rinnai-australia/Legacy-Controls-NWSystem-NCW7/README.md

# Legacy-Controls-NWSystem-NCW7
Legacy Networker System Control - N-CW7 (Embedded Wi-Fi Option)
