rinnai-australia/Legacy-Controls-NWSystem-NCW7/(list of files, drawings)

Other design files:
Hardware/Rev00/N-CW7_Main.SchDoc
Hardware/Rev00/N-CW7_PWR_TWB.SchDoc
Hardware/Rev00/N-CW7_UserInterface.SchDoc
Hardware/Rev00/N-CW7Rev00.PrjPcb
Hardware/Rev01/N-CW7_Main.SchDoc
Hardware/Rev01/N-CW7_PWR_TWB.SchDoc
Hardware/Rev01/N-CW7_UserInterface.SchDoc
Hardware/Rev01/N-CW7Rev01.PrjPcb
