rinnai-australia/Legacy-Controls-NWSystem-NCW7/Firmware/NCW7/Source/DeviceFiles/MicrocontrollerAccess/mcuaxess_def.h

//*********************************************************************************************************************************************************************************
// mcuaxess_def.h
/*---------------------------------------------------------------------------------------------------------------------------------------------------------------------------------
 * Description: Microcontoller Access - Global Definitions.
 *
 * --------------------------------------------------------------------------------------------------------------
 * Port Pin Usage													Peripheral		Pin Configuration
 * --------------------------------------------------------------------------------------------------------------
 *	GPIOA
 *	.0  -	EEPROM WC pin.
 *	.1	-	FSH_CS1#
 *	.2	-	External interface Tx-Line.
 *	.3 	-	External interface Rx-Line.
 *	.4  -	FT800 Interrupt
 *	.5	-	FT800 SPI SCK
 *	.6	-	FT800 SPI MISO
 *	.7	-	FT800 SPI MOSI
 *	.8  -	Spare01
 *	.9  -	USB RX
 *  .10 - 	USB TX
 *  .11 -	WIFI PWR
 *  .12 - 	WIFI DTS
 *  .13 -	JTAG TMS
 *  .14 -	JTAG TCK
 *  .15 - 	JTAG TDI
 *
 *	GPIOB
 *  .0  -	Vddmes
 *  .1  - 	THM MES
 *  .2  -	BOOT1
 *	.3	-	JTAG TDO
 *	.4  - 	JTAG RESET#
 *  .5  -	WIFI ADHOC
 *  .6  - 	I2C SCL.												I2C1			OD Output @50MHz.
 *  .7  -	I2C SDA.												I2C1			OD Output @50MHz.
 *  .8  -	WIFI RESET#
 *  .9  -	WIFI WAKE
 *  .10 -	RAM HOLD#
 *  .11	- 	uSD CARD DETECT
 *  .12 -	uSD CARD CS#
 *  .13 - 	MEM SPI SCK
 *  .14 - 	MEM SPI MISO
 *  .15 - 	MEM SPI MOSI
 *
 *	GPIOC
 *  .0  -	RTC SQW
 *  .1  -	USB REG
 *  .2	-	ACL INT#
 *  .3	-	MON 5VUSB
 *  .4  -	FT800 CS#
 *  .5  -	FT800 PD#
 *  .6  -	WIFI DFLT#
 *  .7  -   TWB PWR
 *  .8  -  	WIFI CNS
 *  .9	-   WIFI AST
 *  .10 -	WIFI RX
 *  .11 -	WIFI TX
 *  .12 -	TWB TX
 *  .13	-	MON_12VLINE
 *
 *	GPIOD
 *	.2 -	TWB RX
 *
 *---------------------------------------------------------------------------------------------------------------------------------------------------------------------------------
 * Release Information.
 *---------------------------------------------------------------------------------------------------------------------------------------------------------------------------------
 *
 * Version:		N-C7  	   - v090
 * Date:		01/10/2020
 * Modifier:  	Emilio R. La Greca
 *
 * Original release.
 *
 *-------------------------------------------------------------------------------------------------------------------------------------------------------------------------------*/

#ifndef 	MCUAXESS_DEF_H_
#define	 	MCUAXESS_DEF_H_

//*********************************************************************************************************************************************************************************
// APPLICATION
//---------------------------------------------------------------------------------------------------------------------------------------------------------------------------------
// CONSTANTS
//---------------------------------------------------------------------------------------------------------------------------------------------------------------------------------
//	System Clocks & Pre-Scaling
//---------------------------------------------------------------------------------------------------------------------------------------------------------------------------------
#define			PRE_SCALER_AHB				1							// AHB Bus Pre-Scaling					- 2
#define			PRE_SCALER_APB1				2							// APB1 Bus Pre-Scaling					- 2
#define			PRE_SCALER_APB2				1							// APB2 Bus Pre-Scaling					- 1

#define			PRE_SCALER_ADC				8							// ADC Pre-Scaling						- 2

#define			HSECLOCK					8000000						// External clock frequency				- 8MHz
#define			PLLCLK						(HSECLOCK*9)				// PLL -> HSECLOCK * 9 = 72MHz			- 72MHz

#define			SYSCLK						PLLCLK						// SYSCLK								- 72MHz

#define			HCLK						(SYSCLK/PRE_SCALER_AHB)		// HCLK									- 72MHz
#define			PCLK1						(HCLK/PRE_SCALER_APB1)		// PCLK1								- 36MHz
#define			PCLK2						(HCLK/PRE_SCALER_APB2)		// PCLK2								- 72MHz
#define			TIM2CLK						PCLK1						// TIM2CLK								- 36MHz
#define			ADCCLK						(PCLK2/PRE_SCALER_ADC)		// ADCCLK								- 6MHz
//---------------------------------------------------------------------------------------------------------------------------------------------------------------------------------
//	System Interrupt Priority Levels
//---------------------------------------------------------------------------------------------------------------------------------------------------------------------------------
#define			MCUAXESS_DEF__IP_SYSTICK	14							// 10ms system tick timer
#define			MCUAXESS_DEF__IP_RTC_SECI	13							// RTC Seconds Interrupt Priority

#define			MCUAXESS_DEF__IP_USART1		12							// USART1 Interrupt Priority (USB to Serial)
#define			MCUAXESS_DEF__IP_UART5		13							// UART5 Interrupt Priority  (TWB)

#define			MCUAXESS_DEF__IP_SPI1_HI	13							// SPI1 interrupt		- FT800 SPI (Hi priority)
#define			MCUAXESS_DEF__IP_SPI1_LO	15							// SPI1 interrupt		- FT800 SPI (Lo priority)

#define			MCUAXESS_DEF__IP_I2C1_EV	13							// I2C1 EV Interrupt Priority
#define			MCUAXESS_DEF__IP_I2C1_ER	13							// I2C1 ER Interrupt Priority

#define			MCUAXESS_DEF__IP_TIM6		13							// TIM6 Interrupt Priority
//
// The following bits have not been defined in the "stm32f10x.h" file??
#if defined(STM32F10X_XL)

#define  RCC_APB1ENR_TIM6EN                 ((uint32_t)0x00000010)     	/*!< TIM6 Timer clock enable */
#define  RCC_APB1ENR_UART4EN                ((uint32_t)0x00080000)      /*!< UART 4 clock enable - Added manually, emilio */
#define  RCC_APB1ENR_UART5EN                ((uint32_t)0x00100000)      /*!< UART 5 clock enable - Added manually, emilio */

#endif /* STM32F10X_XL */
//---------------------------------------------------------------------------------------------------------------------------------------------------------------------------------
//	STRUCTURES
//---------------------------------------------------------------------------------------------------------------------------------------------------------------------------------
//
//---------------------------------------------------------------------------------------------------------------------------------------------------------------------------------
// VARIABLES
//---------------------------------------------------------------------------------------------------------------------------------------------------------------------------------
//
//---------------------------------------------------------------------------------------------------------------------------------------------------------------------------------
// SAVED VALUES
//---------------------------------------------------------------------------------------------------------------------------------------------------------------------------------
//
//---------------------------------------------------------------------------------------------------------------------------------------------------------------------------------
// TIMING
//---------------------------------------------------------------------------------------------------------------------------------------------------------------------------------
//
//---------------------------------------------------------------------------------------------------------------------------------------------------------------------------------
// FUNCTION DECLARES
//---------------------------------------------------------------------------------------------------------------------------------------------------------------------------------
//
//*********************************************************************************************************************************************************************************

#endif /* MCUAXESS_DEF_H_ */
