rinnai-australia/Legacy-Controls-NWSystem-NCW7/Firmware/NCW7/Source/SystemApplication/Management/UserInterface/TFTDisplay/Images/Heating/uitftdsp_image_heating.c

//*********************************************************************************************************************************************************************************
// uitftdsp_image_heating.c
/*---------------------------------------------------------------------------------------------------------------------------------------------------------------------------------
 * Release Information.
 *---------------------------------------------------------------------------------------------------------------------------------------------------------------------------------
 *
 * Version:		N-C7  	   - v090
 * Date:		01/10/2020
 * Modifier:  	Emilio R. La Greca
 *
 * Original release.
 *
 *-------------------------------------------------------------------------------------------------------------------------------------------------------------------------------*/

#include		<com_defn.h>
#include		<uitftdsp_image_heating.h>
#include		<uitftdsp_image_common.h>

//*********************************************************************************************************************************************************************************
// MODULE
//---------------------------------------------------------------------------------------------------------------------------------------------------------------------------------
// CONSTANTS
//---------------------------------------------------------------------------------------------------------------------------------------------------------------------------------
// INDIVIDUAL IMAGE TABLES - As images added update : mkaHeatingImageDefinition[], and
//													  UITFTDSP_IMAGE_HEATING__MAX_IMAGES.
//---------------------------------------------------------------------------------------------------------------------------------------------------------------------------------
// ('file properties: ', 'resolution ', 50, 'x', 112, 'format ', 'ARGB1555', 'stride ', 100, ' total size ', 11200) - flame_icon_141210
static const uint8_t 	mkaucFlameIcon[11200] =
{
		255,127,255,127,255,127,255,127,255,127,255,127,255,127,  0,124,  0,124,  0,124,  0,124,  0,124,  0,124,  0,124,  0,124,  0,124,  0,124,  0,124,  0,124,  0,124,  0,124,  0,124,  0,124,  0,124,  0,124,  0,124,  0,124,  0,124,  0,124,  0,124,  0,124,  0,124,  0,124,  0,124,  0,124,  0,124,  0,124,  0,124,  0,124,255,127,255,127,255,127,255,127,255,127,255,127,255,127,255,127,255,127,255,127,255,127,
		255,127,255,127,255,127,255,127,255,127,255,127,255,127,  0,124,  0,124,  0,124,  0,124,  0,124,  0,124,  0,124,  0,124,  0,124,  0,124,  0,124,  0,124,  0,124,  0,124,  0,124,  0,124,  0,124,  0,124,  0,124,  0,124,  0,124,  0,124,  0,124,  0,124,  0,124,  0,124,  0,124,  0,124,  0,124,  0,124,  0,124,  0,124,255,127,255,127,255,127,255,127,255,127,255,127,255,127,255,127,255,127,255,127,255,127,
		255,127,255,127,255,127,255,127,255,127,255,127,255,127,  0,124,  0,124,  0,124,  0,124,  0,124,  0,124,  0,124,  0,124,  0,124,  0,124,  0,124,  0,252,  0,124,  0,124,  0,124,  0,124,  0,124,  0,124,  0,124,  0,124,  0,124,  0,124,  0,124,  0,124,  0,124,  0,124,  0,124,  0,124,  0,124,  0,124,  0,124,  0,124,255,127,255,127,255,127,255,127,255,127,255,127,255,127,255,127,255,127,255,127,255,127,
		255,127,255,127,255,127,255,127,255,127,255,127,255,127,  0,124,  0,124,  0,124,  0,124,  0,124,  0,124,  0,124,  0,124,  0,124,  0,124,  0,124,  0,252,  0,124,  0,124,  0,124,  0,124,  0,124,  0,124,  0,124,  0,124,  0,124,  0,124,  0,124,  0,124,  0,124,  0,124,  0,124,  0,124,  0,124,  0,124,  0,124,  0,124,255,127,255,127,255,127,255,127,255,127,255,127,255,127,255,127,255,127,255,127,255,127,
		255,127,255,127,255,127,255,127,255,127,255,127,255,127,  0,124,  0,124,  0,124,  0,124,  0,124,  0,124,  0,124,  0,124,  0,124,  0,124,  0,124,  0,252,  0,252,  0,124,  0,124,  0,124,  0,124,  0,124,  0,124,  0,124,  0,124,  0,124,  0,124,  0,124,  0,124,  0,124,  0,124,  0,124,  0,124,  0,124,  0,124,  0,124,255,127,255,127,255,127,255,127,255,127,255,127,255,127,255,127,255,127,255,127,255,127,
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
// Collection of all images
static const struct	UITFTDSP_IMAGE_COMMON__ImageDefinition	mkaHeatingImageDefinition[UITFTDSP_IMAGE_HEATING__MAX_IMAGES] = {

	{ mkaucFlameIcon, 			sizeof(mkaucFlameIcon), 		   100,  50, 112 },
	{ mkaucLightningBoltIcon, 	sizeof(mkaucLightningBoltIcon),     96,  48, 112 },			// Added, NC7090_DFDISP
};
//---------------------------------------------------------------------------------------------------------------------------------------------------------------------------------
// VARIABLES
//---------------------------------------------------------------------------------------------------------------------------------------------------------------------------------
static UITFTDSP_IMAGE_COMMON__ImageDetails	maHeatingImage[UITFTDSP_IMAGE_HEATING__MAX_IMAGES];
//---------------------------------------------------------------------------------------------------------------------------------------------------------------------------------
// SAVED VALUES
//---------------------------------------------------------------------------------------------------------------------------------------------------------------------------------
//
//---------------------------------------------------------------------------------------------------------------------------------------------------------------------------------
// TIMING
//---------------------------------------------------------------------------------------------------------------------------------------------------------------------------------
//
//---------------------------------------------------------------------------------------------------------------------------------------------------------------------------------
// FUNCTION DECLARES
//---------------------------------------------------------------------------------------------------------------------------------------------------------------------------------
//
//*********************************************************************************************************************************************************************************


//*********************************************************************************************************************************************************************************
// APPLICATION
//---------------------------------------------------------------------------------------------------------------------------------------------------------------------------------
// VARIABLES
//---------------------------------------------------------------------------------------------------------------------------------------------------------------------------------
//
//---------------------------------------------------------------------------------------------------------------------------------------------------------------------------------
// FUNCTION DEFINITIONS
/*---------------------------------------------------------------------------------------------------------------------------------------------------------------------------------
 * @brief:	Initialise heating specific image interface.
 * @param:	None.
 * @retval:	None.
 *-------------------------------------------------------------------------------------------------------------------------------------------------------------------------------*/
void									UITFTDSP_IMAGE_HEATING__Initialise(void)
{
	uint16_t	uiIndex;

	for ( uiIndex = 0; uiIndex < UITFTDSP_IMAGE_HEATING__MAX_IMAGES; uiIndex++ )
	{
		maHeatingImage[uiIndex].ulRAMStartAddx = 0;
	}

	return;
}
/*--------------------------------------------------------------------------------------------------------------------------------
 * @brief:	Returns a pointer to the image details.
 * @param:	vImageNumber:
 * 				- the image number of type : UITFTDSP_IMAGE_HEATING__IMAGE_NUMBER.
 * @retval:	Pointer to UITFTDSP_IMAGE_COMMON__ImageDetails.
 *------------------------------------------------------------------------------------------------------------------------------*/
UITFTDSP_IMAGE_COMMON__ImageDetails*	UITFTDSP_IMAGE_HEATING__pImage(UITFTDSP_IMAGE_HEATING__IMAGE_NUMBER vImageNumber)
{
	UITFTDSP_IMAGE_COMMON__ImageDetails*	pImage = COM_DEFN__NULL;

	if ( vImageNumber < UITFTDSP_IMAGE_HEATING__MAX_IMAGES )
	{
		// Get the image using number as index
		pImage = &maHeatingImage[vImageNumber];
		// Assign the image definition details
		pImage->pDefinition = &mkaHeatingImageDefinition[vImageNumber];
	}

	return pImage;
}
//*********************************************************************************************************************************************************************************
