rinnai-australia/Legacy-Controls-NWSystem-NCW7/Firmware/NCW7/Source/SystemApplication/Management/NetworkerSystem/Access/Ancillary/PinEntry/Control/nws_pinent_control.h

//*********************************************************************************************************************************************************************************
// nws_pinent_control.h
/*---------------------------------------------------------------------------------------------------------------------------------------------------------------------------------
 * Description: Networker System Ancillary State - Pin Entry Control.
 *
 * 				Code module to allow access to pin entry in networker system.
 *---------------------------------------------------------------------------------------------------------------------------------------------------------------------------------
 * Release Information.
 *---------------------------------------------------------------------------------------------------------------------------------------------------------------------------------
 *
 * Version:		N-C7 	   - v090
 * Date:		01/10/2020
 * Modifier:  	Emilio R. La Greca
 *
 * Original release.
 *
 *-------------------------------------------------------------------------------------------------------------------------------------------------------------------------------*/

#ifndef 		NWS_PINENT_CONTROL_H_
#define 		NWS_PINENT_CONTROL_H_

#include		<com_defn.h>
#include		<nws_pinent_common.h>
#include		<genstrdt.h>

//*********************************************************************************************************************************************************************************
// APPLICATION
//---------------------------------------------------------------------------------------------------------------------------------------------------------------------------------
// CONSTANTS
//---------------------------------------------------------------------------------------------------------------------------------------------------------------------------------
typedef enum	NWS_PINENT_CONTROL__PIN_ACCESS {		// Pin Access States
														//
	NWS_PINENT_CONTROL__PA__NOT_REQUIRED  = 0,			// - Not required (default state)
	NWS_PINENT_CONTROL__PA__REQUIRED      = 1,			// - Required to access a state
	NWS_PINENT_CONTROL__PA__GRANTED   	  = 2,			// - Pin access granted
	NWS_PINENT_CONTROL__PA__CANCELLED 	  = 3			// - Pin access cancelled

} NWS_PINENT_CONTROL__PIN_ACCESS;
//---------------------------------------------------------------------------------------------------------------------------------------------------------------------------------
// STRUCTURES
//---------------------------------------------------------------------------------------------------------------------------------------------------------------------------------
//
//---------------------------------------------------------------------------------------------------------------------------------------------------------------------------------
// VARIABLES
//---------------------------------------------------------------------------------------------------------------------------------------------------------------------------------
//
//---------------------------------------------------------------------------------------------------------------------------------------------------------------------------------
// SAVED VALUES
//---------------------------------------------------------------------------------------------------------------------------------------------------------------------------------
//
//---------------------------------------------------------------------------------------------------------------------------------------------------------------------------------
// TIMING
//---------------------------------------------------------------------------------------------------------------------------------------------------------------------------------
//
//---------------------------------------------------------------------------------------------------------------------------------------------------------------------------------
// FUNCTION DECLARES
//---------------------------------------------------------------------------------------------------------------------------------------------------------------------------------
extern void					NWS_PINENT_CONTROL__InitBeforeStateEntry();
extern void					NWS_PINENT_CONTROL__UserifUpdate(bool vbStateJustEntered, NWS_PINENT_COMMON__PinEntryDetails* pPinEntryAppInterface, NWS_PINENT_CONTROL__PIN_ACCESS* pPinAccess);

extern void					NWS_PINENT_CONTROL__UserifUpdate_GetPinNumber(bool vbStateJustEntered, NWS_PINENT_COMMON__PinEntryDetails* pPinEntryAppInterface);

extern GENSTRDT__String*	NWS_PINENT_CONTROL__pPinNumberEntered(void);
extern bool					NWS_PINENT_CONTROL__bButtonPressed_Ok(void);
extern bool					NWS_PINENT_CONTROL__bButtonPressed_Cancel(void);
extern void					NWS_PINENT_CONTROL__FlagPinInvalid(void);
//*********************************************************************************************************************************************************************************

#endif /* NWS_PINENT_CONTROL_H_ */
