rinnai-australia/Legacy-Controls-NWSystem-NCW7/Firmware/NCW7/Source/DeviceFiles/MicrocontrollerAccess/mcuaxess.c

//*********************************************************************************************************************************************************************************
// mcuaxess.c
/*---------------------------------------------------------------------------------------------------------------------------------------------------------------------------------
 * Release Information.
 *---------------------------------------------------------------------------------------------------------------------------------------------------------------------------------
 *
 * Version:		N-C7  	   - v090
 * Date:		01/10/2020
 * Modifier:  	Emilio R. La Greca
 *
 * Original release.
 *
 *-------------------------------------------------------------------------------------------------------------------------------------------------------------------------------*/

#include		<com_defn.h>
#include		<mcuaxess.h>
#include		<mcuaxess_def.h>

//*********************************************************************************************************************************************************************************
// MODULE
//---------------------------------------------------------------------------------------------------------------------------------------------------------------------------------
// CONSTANTS
//---------------------------------------------------------------------------------------------------------------------------------------------------------------------------------
#define			MCUAXESS__SYSTEM_TIMEBASE_MS					10

#define			MCUAXESS__TOGGLE_SWITCH_DEBOUNCE_TIMING_TBUI	(20 / GENTIMDT__kucUI_TIMEBASE_10MS)
//---------------------------------------------------------------------------------------------------------------------------------------------------------------------------------
// VARIABLES
//---------------------------------------------------------------------------------------------------------------------------------------------------------------------------------
//
//---------------------------------------------------------------------------------------------------------------------------------------------------------------------------------
// SAVED VALUES
//---------------------------------------------------------------------------------------------------------------------------------------------------------------------------------
//
//---------------------------------------------------------------------------------------------------------------------------------------------------------------------------------
// TIMING
//---------------------------------------------------------------------------------------------------------------------------------------------------------------------------------
//
//---------------------------------------------------------------------------------------------------------------------------------------------------------------------------------
// FUNCTION DECLARES
//---------------------------------------------------------------------------------------------------------------------------------------------------------------------------------
//
//*********************************************************************************************************************************************************************************


//*********************************************************************************************************************************************************************************
// APPLICATION
//---------------------------------------------------------------------------------------------------------------------------------------------------------------------------------
// VARIABLES
//---------------------------------------------------------------------------------------------------------------------------------------------------------------------------------
//
//---------------------------------------------------------------------------------------------------------------------------------------------------------------------------------
// FUNCTION DEFINITIONS
/*---------------------------------------------------------------------------------------------------------------------------------------------------------------------------------
 * @brief:	This function configures the microcontroller ready for operation after a reset.  This function should only be called once after a reset has occurred.
 * @param:	None.
 * @retval:	None.
 *-------------------------------------------------------------------------------------------------------------------------------------------------------------------------------*/
void							MCUAXESS__MicrocontrollerInitialisation(void)
{
	//-----------------------------------------------------------------------------------------------------------------------------------------------------------------------------
	// 1) System Configuration - Clock, PLL & Flash: 	Code from SystemInit() function
	//-----------------------------------------------------------------------------------------------------------------------------------------------------------------------------
	__IO uint32_t StartUpCounter = 0, HSEStatus = 0;
	//
	// Reset the RCC clock configuration to the default reset state(for debug purpose)
	// - Set HSION bit
	RCC->CR |= (uint32_t)0x00000001;
	// - Reset SW, HPRE, PPRE1, PPRE2, ADCPRE and MCO bits
	RCC->CFGR &= (uint32_t)0xF8FF0000;
	// - Reset HSEON, CSSON and PLLON bits
	RCC->CR &= (uint32_t)0xFEF6FFFF;
	// - Reset HSEBYP bit
	RCC->CR &= (uint32_t)0xFFFBFFFF;
	// - Reset PLLSRC, PLLXTPRE, PLLMUL and USBPRE/OTGFSPRE bits
	RCC->CFGR &= (uint32_t)0xFF80FFFF;
	// - Disable all interrupts and clear pending bits
	RCC->CIR = 0x009F0000;
	//
	// SYSCLK, HCLK, PCLK2 and PCLK1 configuration
	// - Enable HSE
	RCC->CR |= ((uint32_t)RCC_CR_HSEON);
	// - Wait till HSE is ready and if Time out is reached exit
	do
	{
		HSEStatus = RCC->CR & RCC_CR_HSERDY; StartUpCounter++;
	}
	while ( ( HSEStatus == 0 ) && ( StartUpCounter != HSE_STARTUP_TIMEOUT ) );
	// - Define HSEStatus flag
	if ( ( RCC->CR & RCC_CR_HSERDY ) != RESET )
	{
		HSEStatus = (uint32_t)0x01;
	}
	else
	{
	    HSEStatus = (uint32_t)0x00;
	}

	if ( HSEStatus == (uint32_t)0x01 )
	{
		// Configure the Flash Latency cycles and enable prefetch buffer
		// - Enable Prefetch Buffer
	    FLASH->ACR |= FLASH_ACR_PRFTBE;
	    // - Flash 0 wait state
	    FLASH->ACR &= (uint32_t)((uint32_t)~FLASH_ACR_LATENCY);
	    FLASH->ACR |= (uint32_t)FLASH_ACR_LATENCY_2;
	    // Configure the System clock frequency, HCLK, PCLK2 and PCLK1 prescalers
	    // - HCLK = SYSCLK
	    RCC->CFGR |= (uint32_t)RCC_CFGR_HPRE_DIV1;
	    // - PCLK2 = HCLK/2
	    RCC->CFGR |= (uint32_t)RCC_CFGR_PPRE2_DIV1;
	    // - PCLK1 = HCLK/2
	    RCC->CFGR |= (uint32_t)RCC_CFGR_PPRE1_DIV2;
	    // - PLL configuration -> (HSE) * 9 = 72MHz
	    RCC->CFGR &= (uint32_t)((uint32_t)~(RCC_CFGR_PLLSRC | RCC_CFGR_PLLXTPRE | RCC_CFGR_PLLMULL));
	    RCC->CFGR |= (uint32_t)(RCC_CFGR_PLLSRC_HSE | RCC_CFGR_PLLMULL9);
	    // - Enable PLL
	    RCC->CR |= RCC_CR_PLLON;
	    // - Wait till PLL is ready
	    while ( ( RCC->CR & RCC_CR_PLLRDY ) == 0 )
	    {
	    }
	    // - Select PLL as system clock source
	    RCC->CFGR &= (uint32_t)((uint32_t)~(RCC_CFGR_SW));
	    RCC->CFGR |= (uint32_t)RCC_CFGR_SW_PLL;
	    // - Wait till PLL is used as system clock source
	    while ( ( RCC->CFGR & (uint32_t)RCC_CFGR_SWS ) != (uint32_t)0x08 )
	    {
	    }
	}
	else
	{
		// If HSE fails to start-up, the application will have wrong clock configuration. User can add here some code to deal with this error
	}
	//
	// Vector Table Relocation in Internal FLASH
  	// SCB->VTOR = FLASH_BASE | VECT_TAB_OFFSET;
	//
	//-----------------------------------------------------------------------------------------------------------------------------------------------------------------------------
	// 2) Enable I/O Port Bus Clocks
	//-----------------------------------------------------------------------------------------------------------------------------------------------------------------------------
	// - GPIOA
	RCC_APB2PeriphClockCmd( RCC_APB2Periph_GPIOA, ENABLE );
	// - GPIOB
	RCC_APB2PeriphClockCmd( RCC_APB2Periph_GPIOB, ENABLE );
	// - GPIOC
	RCC_APB2PeriphClockCmd( RCC_APB2Periph_GPIOC, ENABLE );
	// - GPIOD
	RCC_APB2PeriphClockCmd( RCC_APB2Periph_GPIOD, ENABLE );
	//
	//-----------------------------------------------------------------------------------------------------------------------------------------------------------------------------
	// 3) Setup system tick timer - 10ms interval timer
	//-----------------------------------------------------------------------------------------------------------------------------------------------------------------------------
	// - Set priority for Cortex-M0 system interrupts
	NVIC_SetPriority( SysTick_IRQn, MCUAXESS_DEF__IP_SYSTICK );
	// - Set reload register
	SysTick->LOAD  =  ( ( ( HCLK * MCUAXESS__SYSTEM_TIMEBASE_MS ) / 1000 ) ) - 1;
	// - Load the SysTick counter value
	SysTick->VAL   =  (0x00);
	// - Enable SysTick IRQ and SysTick Timer
	SysTick->CTRL  =  (SysTick_CTRL_CLKSOURCE_Msk) | (SysTick_CTRL_ENABLE_Msk) | (SysTick_CTRL_TICKINT_Msk);
	//
	//-----------------------------------------------------------------------------------------------------------------------------------------------------------------------------
	// 4) Setup system tick timer - 1ms interval timer
	//-----------------------------------------------------------------------------------------------------------------------------------------------------------------------------
	// TIM6 used as 1ms timebase
	// - Enable the peripheral
	RCC->APB1ENR |= RCC_APB1ENR_TIM6EN;
	// - Choose a prescaler of 720 -> 72000000 / 720 = 100000
	TIM6->PSC = 720;
	// - ARR every 1ms
	TIM6->ARR = 100;
	// - Only overflow generates event
	TIM6->CR1 |= TIM_CR1_URS;
	// - Interrupt on overflow
	TIM6->DIER |= TIM_DIER_UIE;
	// - Set priority level and enable interrupt (Global)
	NVIC_SetPriority( TIM6_IRQn, MCUAXESS_DEF__IP_TIM6 ); NVIC_EnableIRQ( TIM6_IRQn );
	// - Start the timer
	TIM6->CR1 |= TIM_CR1_CEN;

	return;
}
/*---------------------------------------------------------------------------------------------------------------------------------------------------------------------------------
 * @brief:	This function starts the independent watchdog timer.
 * @param:	None.
 * @retval:	None.
 *-------------------------------------------------------------------------------------------------------------------------------------------------------------------------------*/
void							MCUAXESS__StartWatchdogCounter(void)
{
	// Start the watchdog
	IWDG->KR = 0xCCCC;

	return;
}
/*---------------------------------------------------------------------------------------------------------------------------------------------------------------------------------
 * @brief:	This function allows update of the independent watchdog with a 50ms timeout
 * @param:	None.
 * @retval:	None.
 *-------------------------------------------------------------------------------------------------------------------------------------------------------------------------------*/
void							MCUAXESS__RefreshWatchdogCounter(void)
{
	// Prescaler value update once status bit cleared
	do { ; } while ( ( (uint8_t)IWDG->SR & IWDG_SR_PVU ) != 0 );
	// Update reload value for 50ms WD timeout - LSI @ 40kHz with pre-scaler = 4 -> 10000 x 50ms = 500
	IWDG->KR = 0x5555; IWDG->PR  = IWDG_PR_PR_1;
	//
	// Reload value update once status bit cleared
	do { ; } while ( ( (uint8_t)IWDG->SR & IWDG_SR_RVU ) != 0 );
	// Update reload value for 50ms WD timeout - LSI @ 40kHz with pre-scaler = 4 -> 10000 x 50ms = 500
	IWDG->KR = 0x5555; IWDG->RLR = 0xFFF;
	//
	// Update the watchdog
	IWDG->KR = 0xAAAA;

	return;
}
/*---------------------------------------------------------------------------------------------------------------------------------------------------------------------------------
 * @brief:	This function resets the micro via the NVIC.
 * @param:	None.
 * @retval:	None.
 *-------------------------------------------------------------------------------------------------------------------------------------------------------------------------------*/
void							MCUAXESS__ResetMicrocontroller(void)
{
	NVIC_SystemReset();
	return;
}
/*---------------------------------------------------------------------------------------------------------------------------------------------------------------------------------
 * @brief:	This function checks to see if a watchdog timeout caused a reset.
 * @param:	None.
 * @retval:	Flag indicating whether or not a watchdog timeout cause the reset.
 *-------------------------------------------------------------------------------------------------------------------------------------------------------------------------------*/
bool							MCUAXESS__bResetCausedByWatchdog(void)
{
	bool		bWatchdogReset = false;

	if ( ( RCC->CSR & RCC_CSR_IWDGRSTF ) != 0 )		// Check flag
	{
		bWatchdogReset = true;
	}

	RCC->CSR |= RCC_CSR_RMVF;						// Clear flag

	return bWatchdogReset;
}
/*---------------------------------------------------------------------------------------------------------------------------------------------------------------------------------
 * @brief:	This function allows the value passed to be saved in the backup domain register at the register position specified.
 * @param:	vuiRegNo - The register within the backup domain to have data written to it.
 * 			vuiValue - The value to save to the backup register.
 * @retval:	None.
 *-------------------------------------------------------------------------------------------------------------------------------------------------------------------------------*/
void 							MCUAXESS__WriteBackupRegister(uint16_t vuiRegNo, uint16_t vuiValue)
{
    __IO uint32_t tmp = 0;

    tmp = (uint32_t)BKP_BASE; tmp += (vuiRegNo * 4);

	*(__IO uint32_t *) tmp = vuiValue;

	return;
}
/*---------------------------------------------------------------------------------------------------------------------------------------------------------------------------------
 * @brief:	This function allows the value saved at the specified backup domain register to be retrieved and returned to the calling code.
 * @param:	vuiRegNo - The register within the backup domain to have data retrieved from.
 * @retval:	The value returned from the backup domain register.
 *-------------------------------------------------------------------------------------------------------------------------------------------------------------------------------*/
uint16_t 						MCUAXESS__uiReadBackupRegister(uint16_t vuiRegNo)
{
    __IO uint32_t tmp = 0;

    tmp = (uint32_t)BKP_BASE; tmp += (vuiRegNo * 4);

    return (*(__IO uint16_t *) tmp);
}
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
