rinnai-australia/Legacy-Controls-NWSystem-NCW7/(commit log)

2025-07-08 Initial Commit - 250708
    [B065642_NC7S_H800177-001.xlsx, N-CW7Rev00.PrjPcb, N-CW7Rev00BOM.xlsx, N-CW7Rev00BOM_IntronicsPN.xlsx, N-CW7Rev01.PrjPcb, N-CW7Rev01BOM.xlsx, N-CW7Rev01BOM_IntronicsPN.xlsx, N-CW7_Main.SchDoc]
2025-07-08 Backup - 250708
    [N-CW7_Main.SchDoc]
